pedroruizf/smartplaces/images/nodo02.jpg

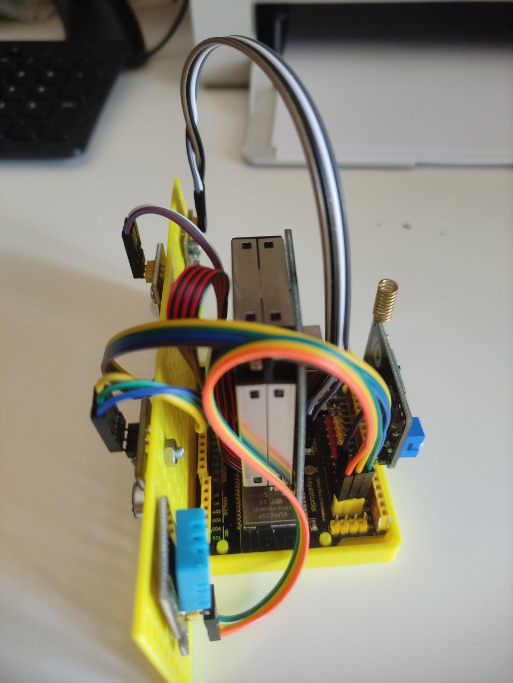
images/nodo02.jpg
