pedroruizf/smartplaces/images/concentrador.jpg

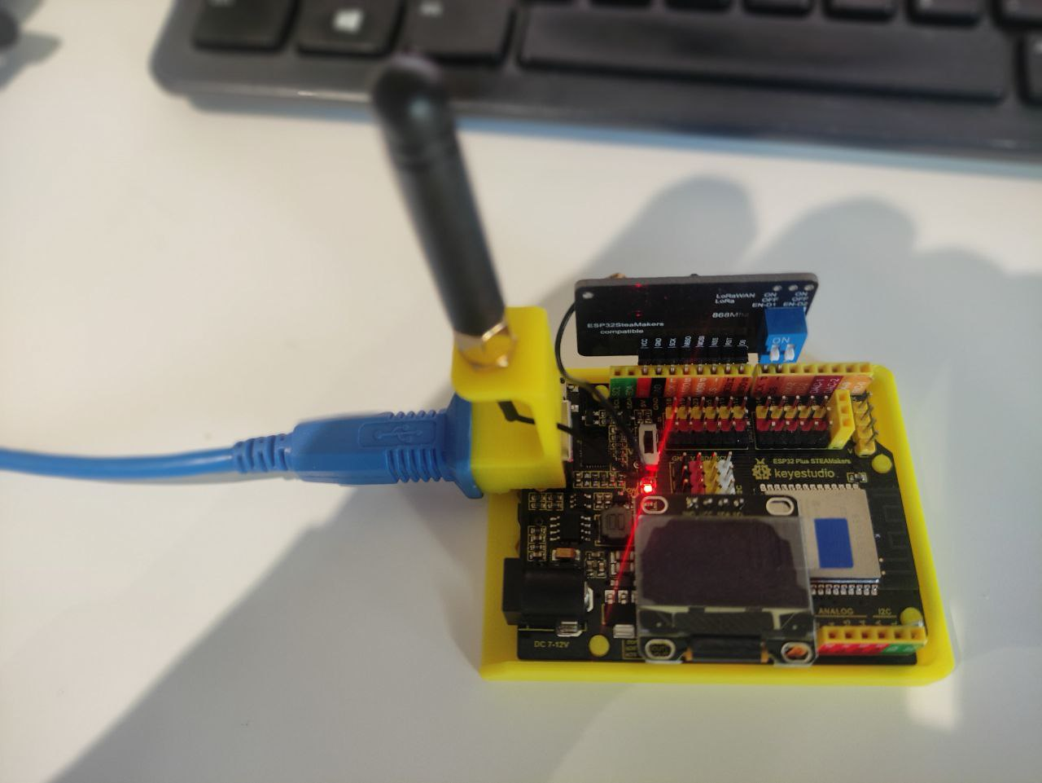
images/concentrador.jpg
