pedroruizf/smartplaces/README.md

# SmartPlaces

## Proyecto de sitios inteligentes con ESP32 STEAMakers + arduinoblocks

La información se encuentra en el repositorio en formato .odt y .pdf.
