pedroruizf/smartplaces/monitorización de lugares.odt

Dos proyecto de monitorización de lugares:

SmartPlaces: se trata de un grupo de estaciones conectadas con un nodo principal o concentrador a través de LoRa. El concentrador va pidiendo los datos a las estaciones a través de radio y los publica en un canal de thingspeak por cada estación. Cada estación además de sus sensores presenta un semáforo de CO2.

https://github.com/pedroruizf/smartplaces

Smarties (Smartsoto): se trata de estaciones independientes conectadas a internet a través de andared, cada una con un canal de thingspeak, cada estación amén de los sensores tiene un semáforo de CO2.

https://github.com/pedroruizf/smarties
