pedroruizf/smartplaces/smartplaces.odt

SmartPlaces

Proyecto de sitios inteligentes

con ESP32 STEAMakers + LoRa +

Por: Pedro Ruiz Fernández

Basado en LoRa y LoRaWAN con Arduinoblocks + ESP32 STEAMakers (por (https://drive.google.com/file/d/1tZecaEcz6yPZwbVpgCbpPG4LeU5A3kPs/view)Juanjo López (https://drive.google.com/file/d/1tZecaEcz6yPZwbVpgCbpPG4LeU5A3kPs/view)) (https://drive.google.com/file/d/1tZecaEcz6yPZwbVpgCbpPG4LeU5A3kPs/view)

# Objetivo

Se trata de monitorizar a través de sensores cualquier centro, interconectando una serie de placas ESP32 STEAMakers a través de tecnología LoRa, con objeto de mantener bajo control y estudio datos como luminosidad, temperatura, humedad, CO2, sonido, micropartículas, etc.

# Diseño 3D

Para el diseño de l (https://drive.google.com/file/d/1jTNkVNKze06sl2cbHl4h5Yz6PgULLwkG/view?usp=sharing)os nodos (estaciones) (https://drive.google.com/file/d/1jTNkVNKze06sl2cbHl4h5Yz6PgULLwkG/view?usp=sharing) de los diferentes espacios, nos hemos basado en el diseño de un alojamiento para arduino uno (https://www.printables.com/es/model/490153-honeycomb-arduino-case) (compatible con la forma de la ESP32 STEAMakers), al que le hemos añadido una rejilla para el atornillado de sensores y actuadores. El alojamiento sin rejilla es el que usaremos para la estación base (concentrador), ya que no tiene sensores.

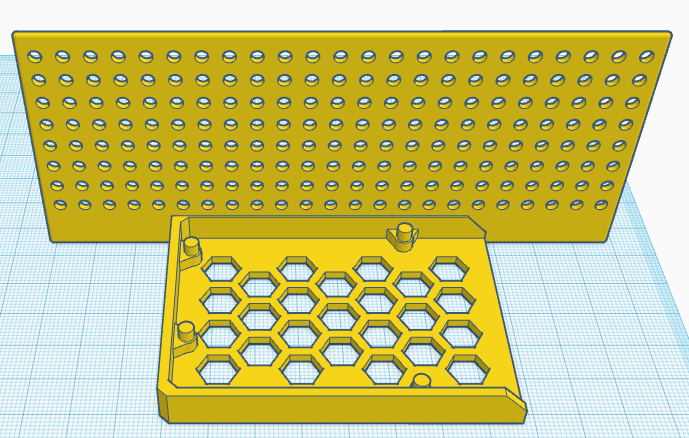
[picture p3: figure]

Figura 2: Diseño 3D nodo

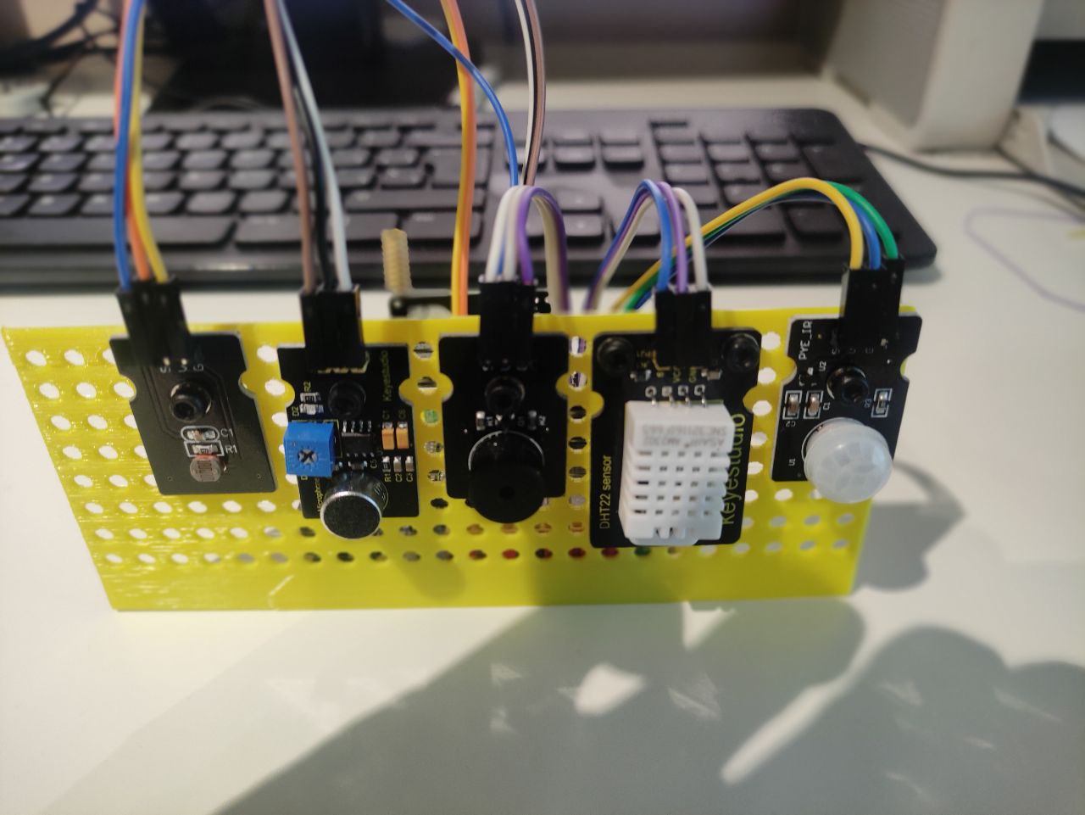
[picture p4: figure]

Figura 1: Foto de nodo

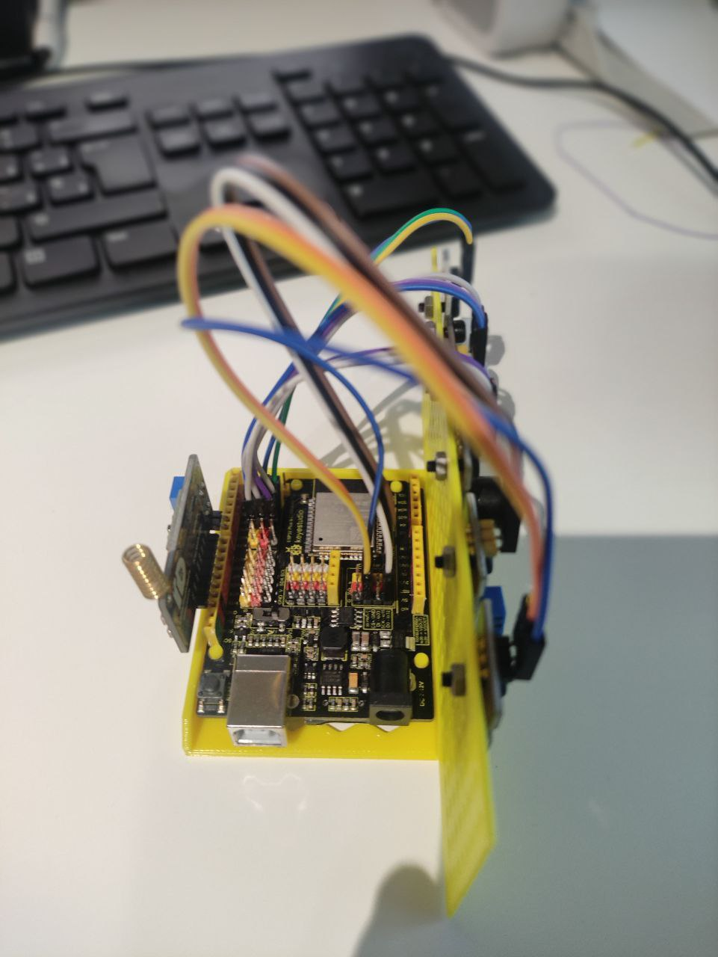
[picture p5: figure]

Figura 3: Foto de nodo perfil


Figura 4: Concentrador

# Componentes electrónicos

Elemento | Imagen | Descripción

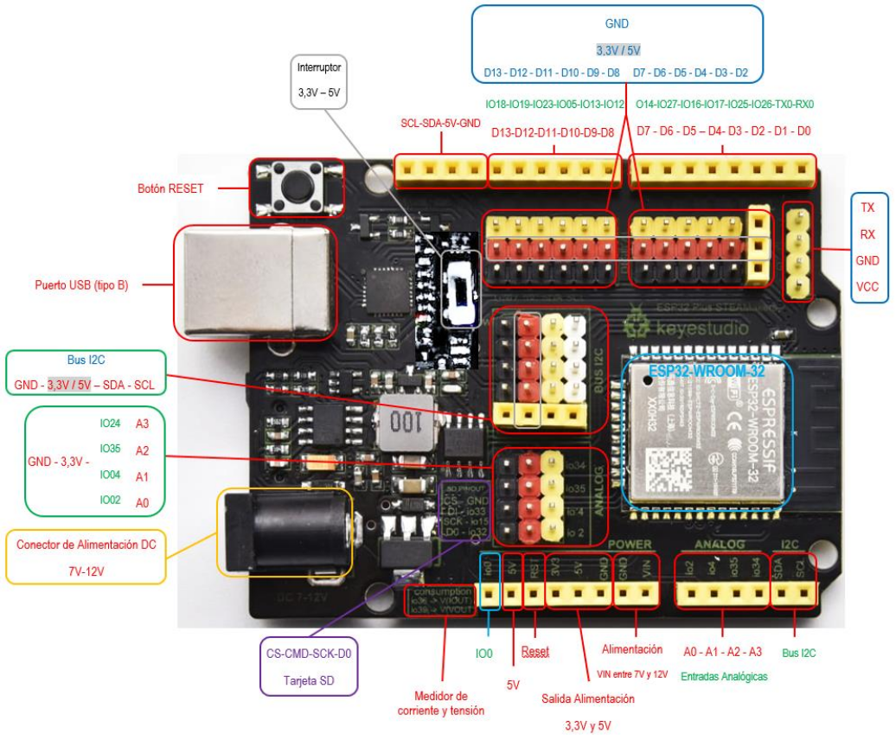
[picture p6: figure]

Placa ESP32 STEAMakers (https://www.dropbox.com/s/dlaxgwj1vx8u1kw/Manual%20Actividades%20ESP32%20SteaMakers%202022_Junio.pdf?dl=0) | | Esp32 fabricada por keyestudio, con factor de forma arduino y con aditamentos como pinout macho, microsd, sensores integrados de energía, programable con arduinoblocks y con una gran documentación disponible. Se usarán una como concentradora o maestra, y tantas como estaciones de datos quieras poner.

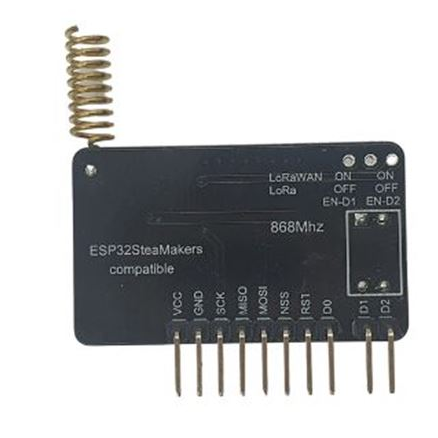
[picture p7: figure]

Módulo Lora - LoraWan (https://shop.innovadidactic.com/es/standard-perifericos/1663-modulo-lora-lorawan-8436574314656.html) | | Periférico con conexionado por puerto SPI, que permite comunicaciones por radio LoRa (Long Range), en este caso entre dos puntos.

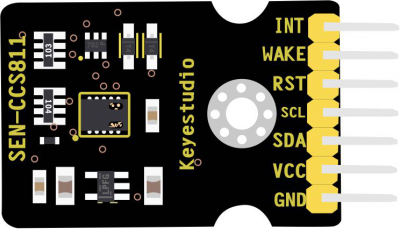
[picture p8: figure]

Sensor (https://wiki.keyestudio.com/KS0457_keyestudio_CCS811_Carbon_Dioxide_Air_Quality_Sensor)CO2 (https://wiki.keyestudio.com/KS0457_keyestudio_CCS811_Carbon_Dioxide_Air_Quality_Sensor) y TVOC | | Sensor que nos da valores de niveles de CO2 en partículas por millón (ppm), y de compuestos volátiles orgánicos TVOC en partículas por billón (ppb). Se conecta a puerto I2C

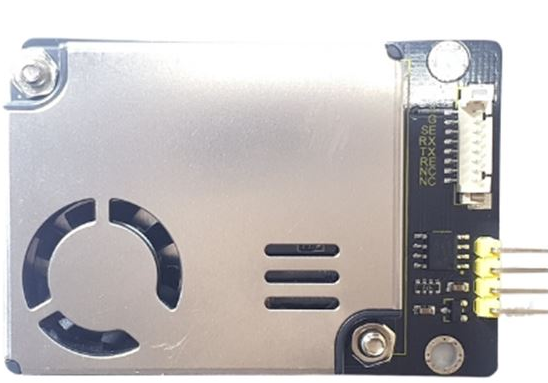
[picture p9: figure]

Sensor de micropartículas PM2.5 (https://shop.innovadidactic.com/es/standard-sensores/1668-keyestudio-sensor-de-microparticulas-pm2-5.html) | | Sensor de micropartículas, nos da valores en microgramos/m³, de partículas de 2,5 Micras y 10 Micras. Se conecta a puerto I2C.

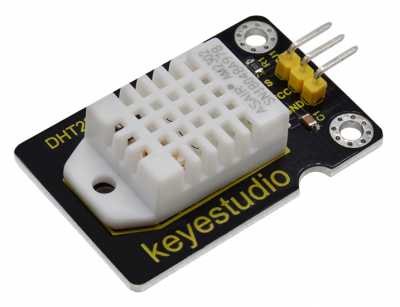
[picture p10: figure]

DHT 22 (https://wiki.keyestudio.com/KS0430_Keyestudio_DHT22_Temperature_and_Humidity_Sensor) | | Sensor digital que nos da valores de humedad y temperatura.

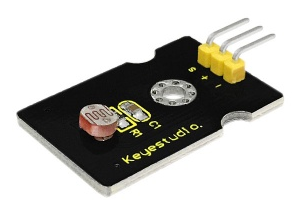
[picture p11: figure]

LDR (https://wiki.keyestudio.com/Ks0028_keyestudio_Photocell_Sensor) | | Sensor analógico que ofrece valores de luminosidad.

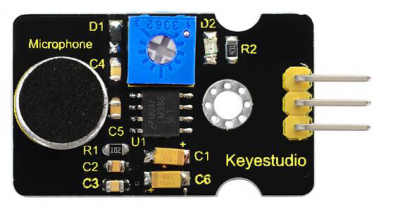
[picture p12: figure]

Micrófono (https://wiki.keyestudio.com/KS0035_Microphone_Sound_Sensor_with_Potentiometer) | | Sensor analógico que mide la cantidad de sonido ambiente.

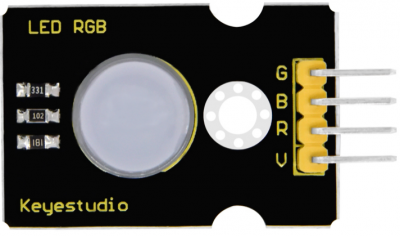
[picture p13: figure]

Led RGB 10mm (https://wiki.keyestudio.com/KS0459_Keyestudio_10mm_Highlight_Full-color_LED_RGB_Module) | | Led RGB de ánodo común de 10 mm.

Como propuesta de sensores y actuadores son los anteriores, pero se pueden usar los que deseemos, lógicamente cambiando posteriormente los programas.

# Conexionado

## Conexionado de concentrador

En el concentrador sólo vamos a necesitar un dispositivo LoRa conectado.

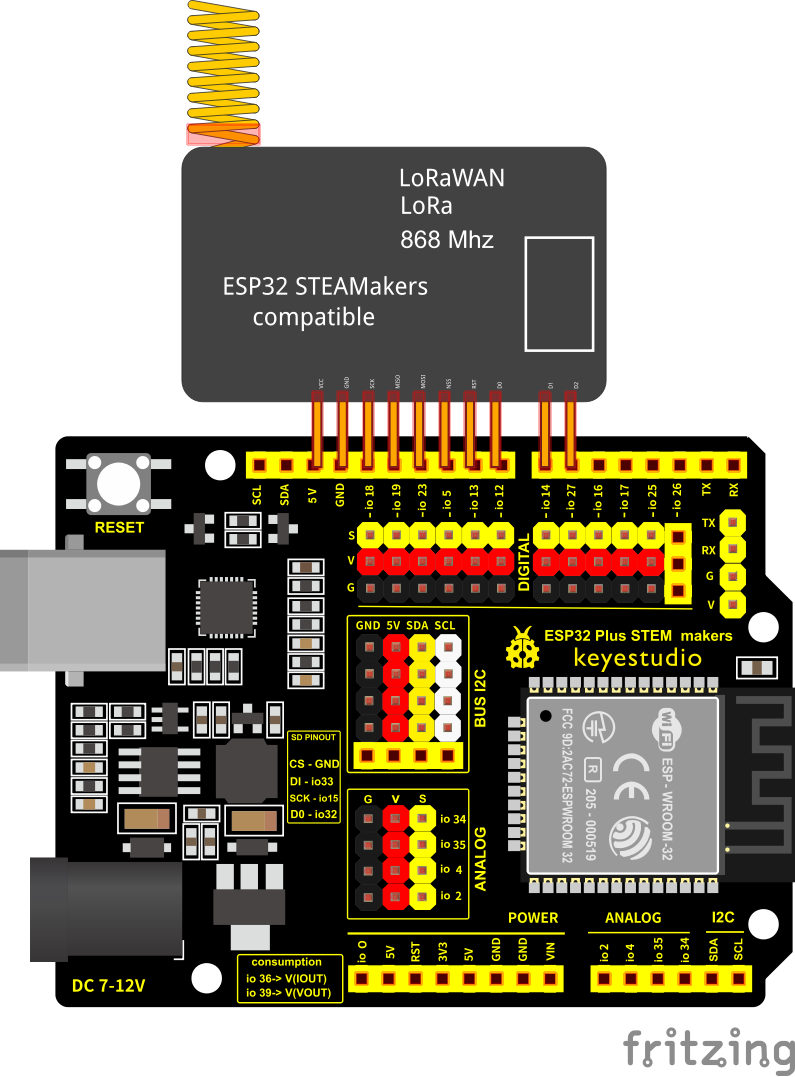
[picture p14: figure]

## Conexionado de cada uno de los nodos

En los nodos vamos a tener un dispositivo LoRa, una LDR (fotoresistencia) conectada a pin analógico A0 (IO2), un micrófono conectado a pin analógico A1 (IO4), un sensor DHT22 (humedad y temperatura) conectado a pin digital 2 (IO25), un sensor de micropartículas conectado a I2C, un sensor de CO2 conectado también a puerto I2C y un led RGB conectado a R pin digital 4 (IO17), G pin digital 5 (IO16), B pin digital 3 (IO25).

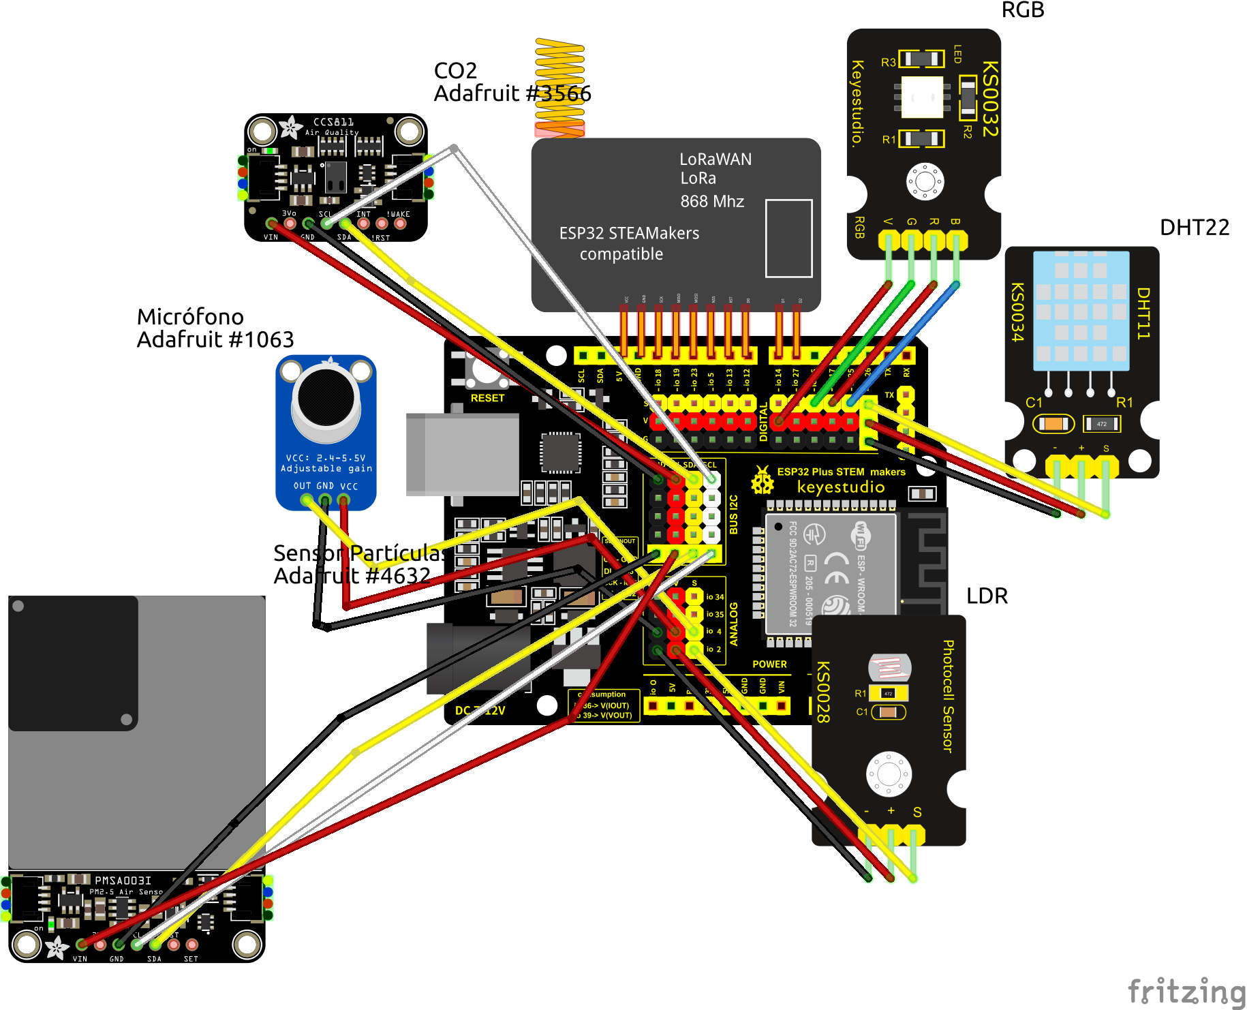
[picture p15: figure]

Dispositivo | Pin
LDR | Pin Analógico0 (IO2)
Micrófono | Pin Analógico 1 (IO4)
DHT22 | Pin Digital 2 (IO26)
Sensor de micropartículas | I2C
Sensor de CO2 y TVOC | I2C
Led RGB | R pin Digital 4 (IO17)
| G pin Digital 5 (IO16)
| B pin Digital 3 (IO 25)

# Programas

## Pro (http://www.arduinoblocks.com/web/project/1685971)grama par (http://www.arduinoblocks.com/web/project/1685971)a (http://www.arduinoblocks.com/web/project/1685971) (http://www.arduinoblocks.com/web/project/1685971)placa concentradora (http://www.arduinoblocks.com/web/project/1685971)

Este programa envía cada 5 minutos en formato JSON una identificación numérica entera, que representa el número de nodo a pedir información, empezando por el 1 e incrementándose de uno en uno. Los nodos están programados para que sólo pueda responder el que tenga el mismo identificador numérico que hemos mandado a todos los nodos, y responden en formato JSON con: su identificador (id), humedad, temperatura, nivel de luz, nivel de sonido, CO2 y micropartículas. Esos datos los analizamos, los asignamos a variables, ~~les añadimos fecha y hora cogida de servidor NTP de internet,~~ ~~los grabamos en ta~~~~r~~~~jeta microSD~~ y lo enviamos a un canal de ThingSpeak dedicado expresamente para el nodo.

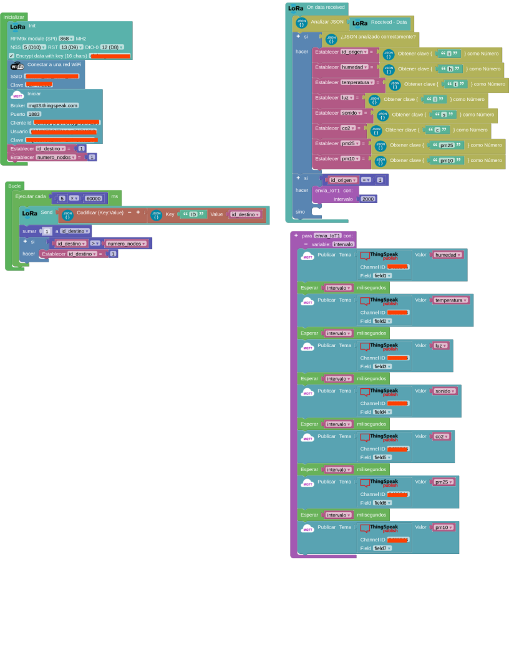
[picture p16: figure]

## Programa para nodos (http://www.arduinoblocks.com/web/project/1682811)

En los nodos, en primer lugar se le asigna un identificador de placa (en establecer id_placa), desde el 1 al n.º de placas que tengamos. El programa recibe un identificador de la placa concentradora y si coincide con el suyo devuelve a la placa maestra los datos de los sensores en formato JSON. Hemos de reseñar que se ha usado en la lectura de la luz el filtro mediana, que da una mediana de los últimos valores medidos (en nuestro caso 5) para evitar fluctuaciones puntuales de los valores. Ver “Filtro mediana en Arduinoblocks (https://docs.google.com/document/u/2/d/e/2PACX-1vT7gu0HE4Mb0ibutH4IJ9s7jnXz-oIVaxtFxKqONtSKfJHmtqPeJytlBzrc8AyI8xMmxfAkU3m17Ycr/pub)”.

Además muestra en un led RGB el nivel de CO2 en forma de código de colores.

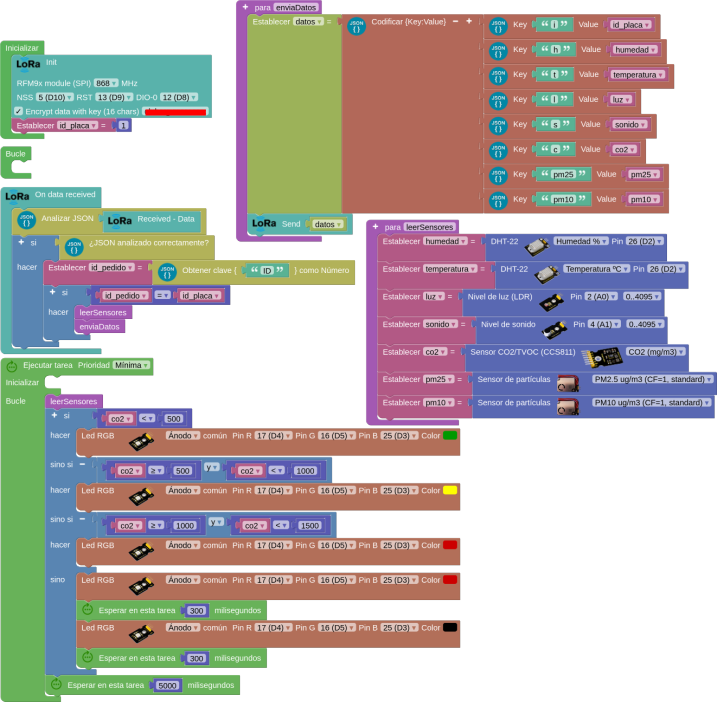
[picture p17: figure]

# Fuentes

- LoRa y LoRaWAN con Arduinoblocks + ESP32 STEAMakers (por (https://drive.google.com/file/d/1tZecaEcz6yPZwbVpgCbpPG4LeU5A3kPs/view)Juanjo López (https://drive.google.com/file/d/1tZecaEcz6yPZwbVpgCbpPG4LeU5A3kPs/view)) (https://drive.google.com/file/d/1tZecaEcz6yPZwbVpgCbpPG4LeU5A3kPs/view)
- Filtro mediana en Arduinoblocks (https://docs.google.com/document/u/2/d/e/2PACX-1vT7gu0HE4Mb0ibutH4IJ9s7jnXz-oIVaxtFxKqONtSKfJHmtqPeJytlBzrc8AyI8xMmxfAkU3m17Ycr/pub)

# Autoría y Licencia

SmartPlace by Pedro Ruiz Fernández is licensed under Attribution-ShareAlike 4.0 International. To view a copy of this license, visit http://creativecommons.org/licenses/by-sa/4.0/
