pedroruizf/smartplaces/images/arduinoblocks_concentrador.png

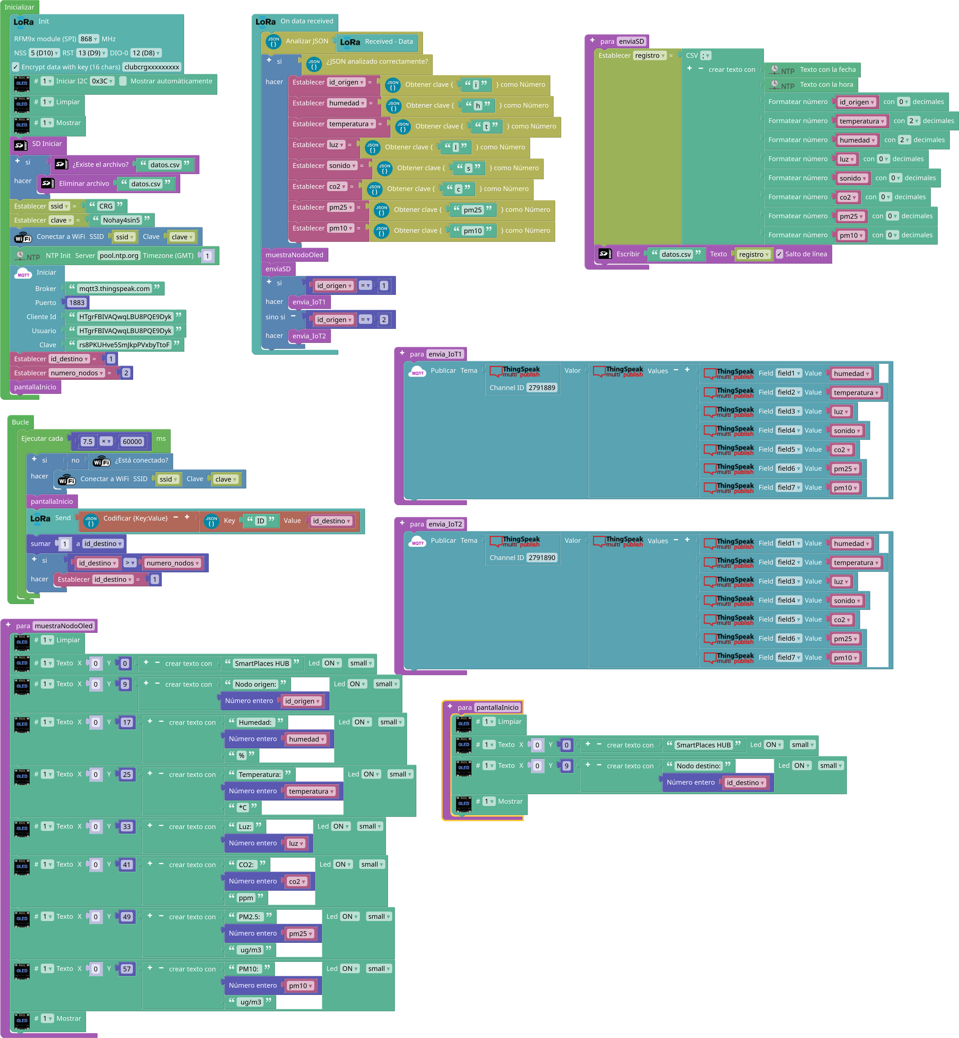
images/arduinoblocks_concentrador.png
