pedroruizf/smartplaces/images/arduinoblocks_nodo.png

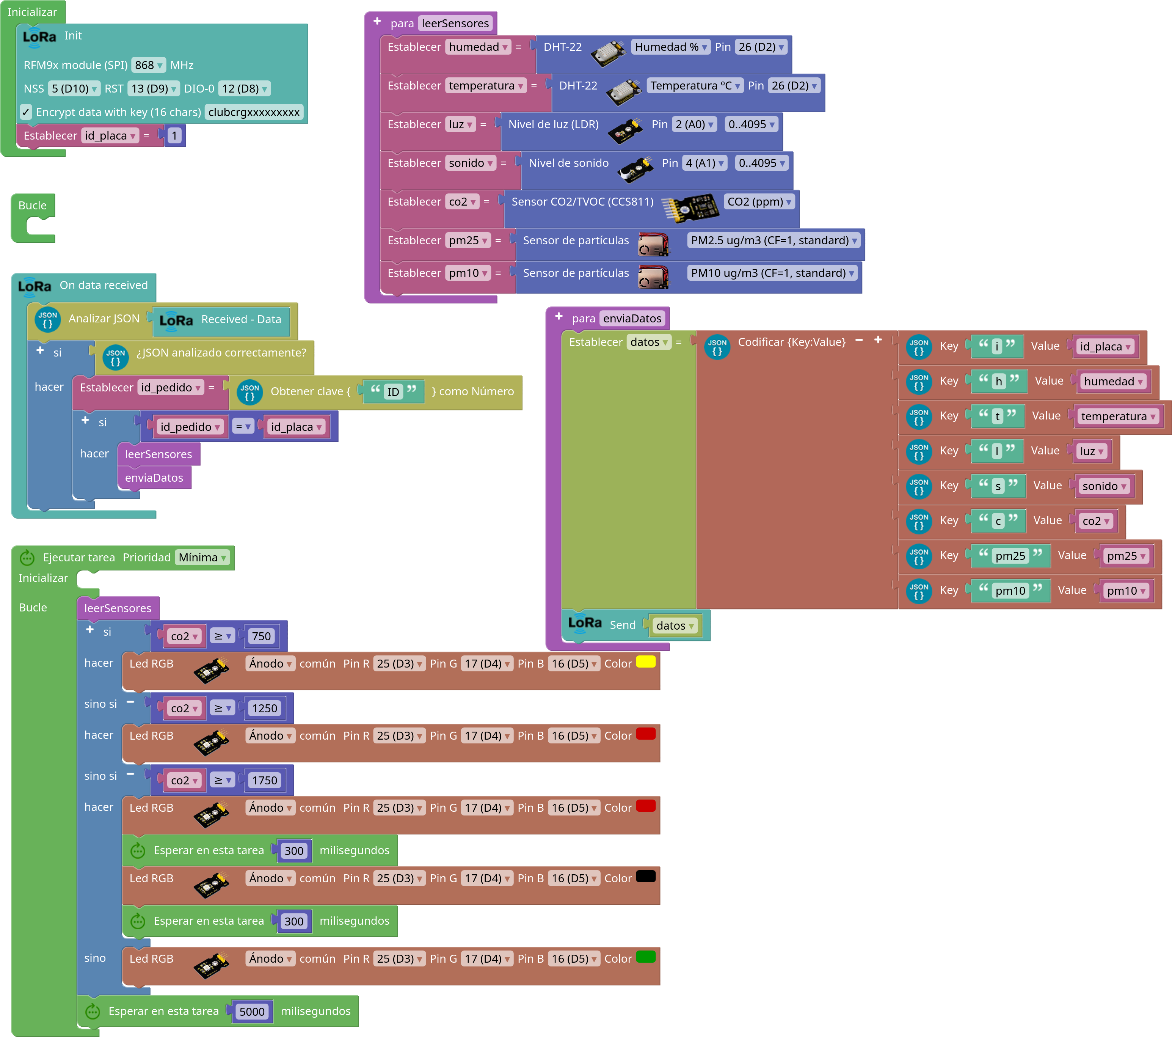
images/arduinoblocks_nodo.png
