pedroruizf/smartplaces/images/nodo01.jpg

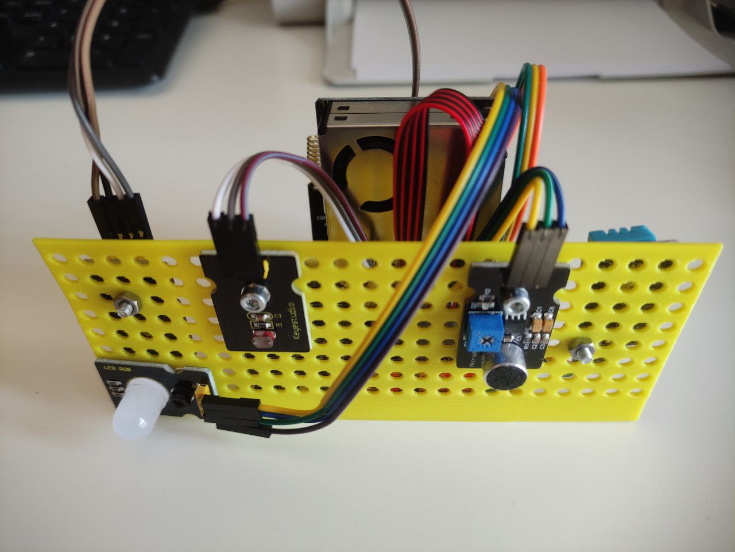
images/nodo01.jpg
