pedroruizf/smartplaces/stl/Honeycomb Arduino case.stl

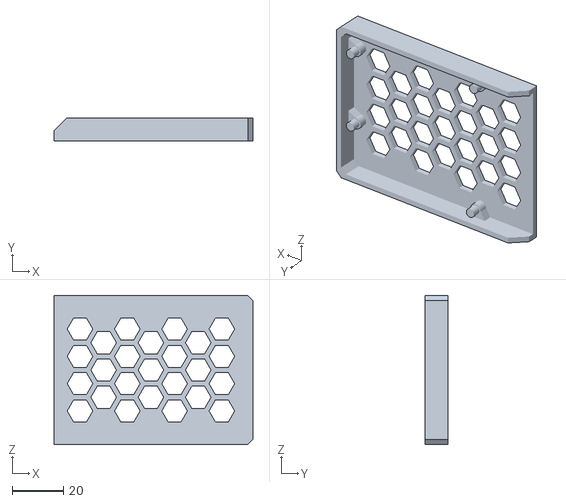
[picture p21: CAD file, 2023-12-30]
stl/Honeycomb Arduino case.stl
77.7 x 9.00 x 58.2
