pedroruizf/smartplaces/stl/smarties_nodo.stl

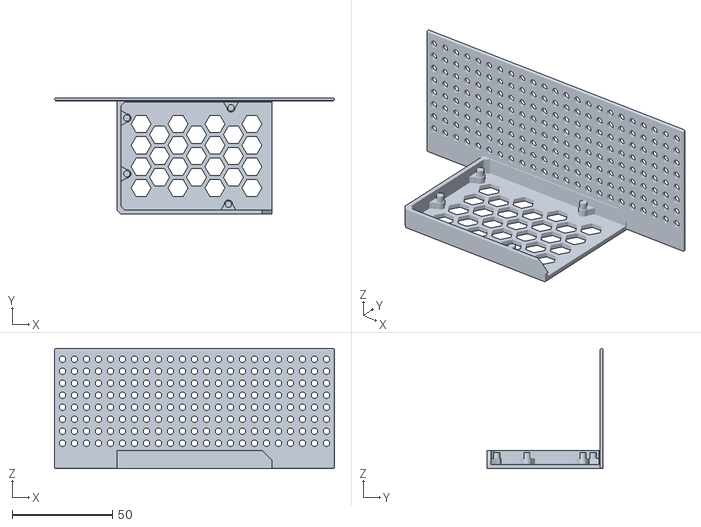
[picture p22: CAD file, 2023-12-30]
stl/smarties_nodo.stl
140.0 x 58.2 x 60.0
