pedroruizf/smartplaces/(list of files, drawings)

Other design files:
fritzing/esp32_lora.fzz
fritzing/esp32_master.fzz
fritzing/esp32_slave.fzz
fritzing/nodo_smartplace.fzz
