pedroruizf/smartplaces/(commit log)

2023-12-30 revisión 3
    [Honeycomb Arduino case.stl, esp32_lora.fzz, esp32_master.fzz, esp32_slave.fzz, smarties_nodo.stl]
2024-03-28 versión mejorada con led indicador co2
    [nodo_smartplace.fzz]
2024-03-31 añadidas mejoras en programa de concentrador
2024-03-31 añadidas mejoras en programa de nodos
2024-04-21 añadidas mejoras en programa de placa concentradora
2024-05-04 corrección de errores
2024-12-22 cambio en programas y conexionado
    [nodo_smartplace.fzz]
2024-12-29 cambios en programas e imágenes de los mismos
